selenalliu/minecraft-pickaxe/(commit log)

2025-04-24 Update pickaxe_controller.ino
    Added missing Wire.h library
    [pickaxe_controller.ino]
2025-04-29 Delete shake_click_test directory
    Already exists in sensor-code
2025-04-30 Added circuit diagram image
2025-05-01 Replaced pickaxe_circuit
    Circuit diagram was wrong
2025-05-01 Update README.md
    Updated circuit image link
2025-05-04 Delete minecraft_pickaxe_circuit.png
    incorrect circuit diagram
2025-05-04 Add files via upload
    Uploaded current circuit diagram
2025-05-04 Update README.md
    Updated README with link to correct circuit diagram
